rylandmarshall22/Small-Engine-Tachometer/README.md

First prototype of the tachometer technology, not polished and not tested for reliability.

This version is not intended to be recreated for general use and was instead used for preliminary testing as a proof of concept for the tachometer.
