rylandmarshall22/Small-Engine-Tachometer/Tach_V0.1_Diagram.png

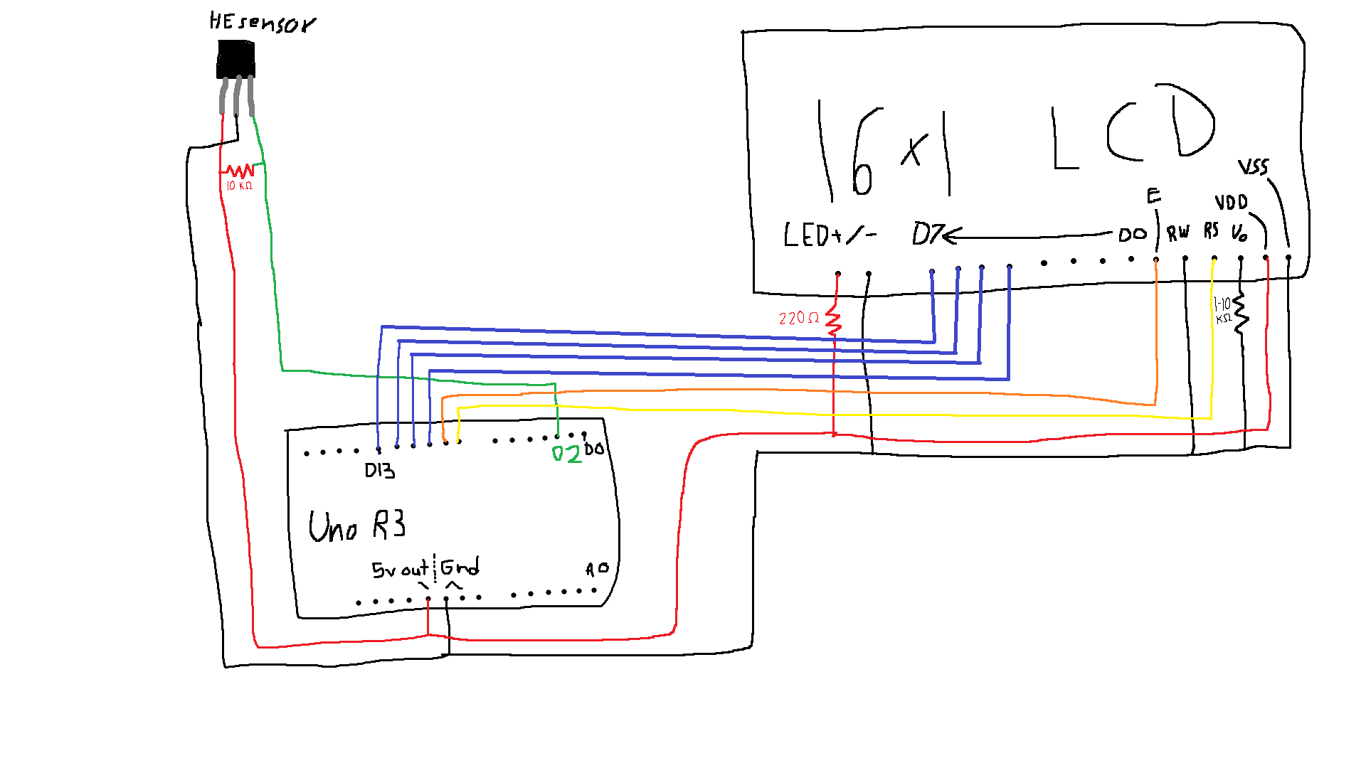
Tach_V0.1_Diagram.png
