rylandmarshall22/Small-Engine-Tachometer/Drill_Flywheel.STL

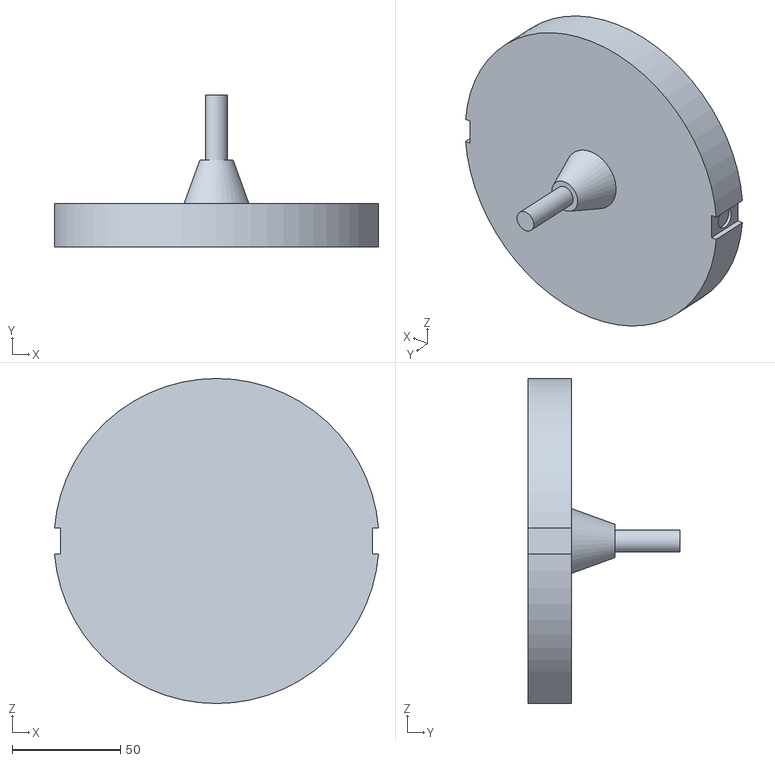
[picture p2: CAD file, 2026-03-05]
Drill_Flywheel.STL
149.5 x 70.0 x 150.0
