rylandmarshall22/Small-Engine-Tachometer/(commit log)

2026-03-03 Create tachometer_code.ino
    Created file for final code to be loaded onto arduino board
2026-03-05 Uploaded prototype tachometer code
    UNTESTED - Compiles but not confirmed to function properly
2026-03-05 Added circuit diagra
    Roughly drawn diagram for tachometer testing prototype
2026-03-05 Uploaded drill flywheel design
    Design for drill flywheel to be used in preliminary prototype testing
    [Drill_Flywheel.STL]
2026-03-06 Added sub-component information
    Instructions on assembling certain components used in the prototype, as well as potential substitutes and pertinent information
2026-03-08 Added updated arduino code for final prototype
2026-03-08 Rename Prototype V0.1 Sub-Components.md to Sub-Components.md
